kezcelm/Bafang-CAN-Battery-Emulator/(commit log)

2026-06-01 Hardcoded test values (BMS readout commented out)
2026-06-01 Battery Time Information
2026-06-12 change to ESP32
